JoseAMS17/MQ4/Documentacion/Plantilla Especificación de requisitos de software IEEE-830.docx

Especificación de requisitos de software

Proyecto: MQ4 — Carrito a control remoto

Revisión 1.00

| | Octubre de 2026

Instrucciones para el uso de este formato

Este formato es una plantilla tipo para documentos de requisitos del software.

Está basado y es conforme con el estándar IEEE Std 830-1998.

Las secciones que no se consideren aplicables al sistema descrito podrán de forma justificada indicarse como no aplicables (NA).

Notas:

Los textos en color azul son indicaciones que deben eliminarse y, en su caso, sustituirse por los contenidos descritos en cada apartado.

Los textos entre corchetes del tipo “” permiten la inclusión directa de texto con el color y estilo adecuado a la sección, al pulsar sobre ellos con el puntero del ratón.

Los títulos y subtítulos de cada apartado están definidos como estilos de MS Word, de forma que su numeración consecutiva se genera automáticamente según se trate de estilos “Titulo1, Titulo2 y Titulo3”.

La sangría de los textos dentro de cada apartado se genera automáticamente al pulsar Intro al final de la línea de título. (Estilos Normal indentado1, Normal indentado 2 y Normal indentado 3).

El índice del documento es una tabla de contenido que MS Word actualiza tomando como criterio los títulos del documento.

Una vez terminada su redacción debe indicarse a Word que actualice todo su contenido para reflejar el contenido definitivo.

De la plantilla de formato del documento © & Coloriuris http://www.qualitatis.org

# Ficha del documento

Fecha | Revisión | Autor | Verificado dep. calidad.
07/10/2026 | 1.00 | Grupo MQ4 — primera redacción completa del documento. Las cifras marcadas PRELIMINAR están pendientes de confirmación. | [Pendiente]

Documento validado por las partes en fecha: [Pendiente]

Por el cliente | Por la empresa suministradora
Fdo. D./ Dña [Pendiente — docente responsable de la asignatura] | Fdo. D./Dña [Pendiente — representante del Grupo MQ4]

# Contenido

# 1 Introducción

Este documento es la especificación de requisitos de software del proyecto MQ4, un carrito de control remoto construido como demostrador de electrónica de potencia, PWM y puente H. Está redactado conforme al estándar IEEE Std 830-1998 [R1] y se organiza en cuatro capítulos: el primero fija el propósito, el alcance, el personal involucrado, las definiciones y las referencias; el segundo describe el producto, sus usuarios, sus restricciones y las suposiciones de las que depende; el tercero recoge los requisitos, que son la parte central del documento; y el cuarto reúne los apéndices. Su contenido parte del levantamiento de requisitos realizado con el docente de la asignatura [R3] [R4] y de la propuesta de proyecto elaborada por el equipo [R2].

## 1.1 Propósito

El propósito de este documento es definir los requisitos necesarios para el diseño y desarrollo del proyecto MQ4, un carrito de control remoto orientado a la aplicación práctica de conceptos de electrónica de potencia y diseño mecatrónico.

El documento está dirigido principalmente a los estudiantes encargados del desarrollo del proyecto y al docente responsable de la asignatura, sirviendo como referencia para establecer las funcionalidades, restricciones, interfaces y características que deberá cumplir el prototipo.

## 1.2 Alcance

El proyecto MQ4 consiste en el diseño y la construcción de un carrito de control remoto orientado a la aplicación práctica de principios de diseño mecatrónico y de electrónica de potencia. El sistema estará compuesto por un vehículo móvil, motores eléctricos, una etapa de potencia basada en un puente H, una unidad de control, un sistema de alimentación mediante baterías, luces delanteras y traseras, y un receptor que se comunica de forma inalámbrica con el control remoto suministrado por el docente de la asignatura.

El control de los motores deberá realizarse mediante señales PWM, lo que permite regular la velocidad de forma gradual y no solo encender y apagar. El puente H permitirá invertir el sentido de giro de los motores, de modo que el vehículo pueda avanzar, retroceder y girar hacia ambos lados. Las luces delanteras y traseras se encenderán y se apagarán por comando del operador.

El control remoto no se diseña ni se construye en este proyecto: es un equipo ya existente, suministrado por el docente, que fue utilizado en la competencia de la NASA en la que participó la universidad. Por lo tanto, el alcance del MQ4 comprende únicamente el lado del vehículo, es decir, el receptor compatible con ese control, la unidad de control, la etapa de potencia, el sistema de luces y el sistema de alimentación. La tecnología concreta del enlace —radiocontrol convencional, Bluetooth, Wi-Fi o ESP-NOW— se determinará al caracterizar el control en la primera etapa del proyecto, y de ese resultado dependen la elección del receptor y la del microcontrolador.

El alcance se limita al manejo remoto del vehículo y al funcionamiento de los motores mediante PWM y puente H. Quedan expresamente fuera del alcance la conducción autónoma, el seguimiento de línea, la detección de obstáculos, el uso de cámara y el envío de telemetría a una computadora o a un teléfono. Dado que el presupuesto disponible es muy limitado, la selección de los componentes deberá realizarse considerando tanto los requisitos técnicos como el costo de implementación y la disponibilidad real de los materiales.

El entregable técnico principal es la placa de circuito impreso diseñada, fabricada y soldada por el equipo, que integra el puente H, el regulador y la unidad de control. No se considera cumplido el alcance si la etapa de potencia se resuelve con un módulo comercial ya armado, porque es precisamente esa placa la que demuestra los temas de la asignatura.

- Identificación del producto(s) a desarrollar mediante un nombre
- Consistencia con definiciones similares de documentos de mayor nivel (ej. Descripción del sistema) que puedan existir

## 1.3 Personal involucrado

Nombre | [Pendiente]
Rol | [Pendiente — por ejemplo: líder de proyecto, diseño de PCB, firmware, mecánica y chasis, documentación]
Categoría profesional | [Pendiente]
Responsabilidades | [Pendiente]
Información de contacto | [Pendiente — correo institucional]
Aprobación | [Pendiente]

Nombre | Junior A. Castillo
Rol | [Pendiente — por ejemplo: líder de proyecto, diseño de PCB, firmware, mecánica y chasis, documentación]
Categoría profesional | Estudiante
Responsabilidades | [Pendiente]
Información de contacto | 20240719@itla.edu.do
Aprobación | [Pendiente]

Nombre | [Pendiente]
Rol | [Pendiente — por ejemplo: líder de proyecto, diseño de PCB, firmware, mecánica y chasis, documentación]
Categoría profesional | [Pendiente]
Responsabilidades | [Pendiente]
Información de contacto | [Pendiente — correo institucional]
Aprobación | [Pendiente]

Nombre | [Pendiente]
Rol | [Pendiente — por ejemplo: líder de proyecto, diseño de PCB, firmware, mecánica y chasis, documentación]
Categoría profesional | [Pendiente]
Responsabilidades | [Pendiente]
Información de contacto | [Pendiente — correo institucional]
Aprobación | [Pendiente]

PENDIENTE. La relación de integrantes del Grupo MQ4 está por completar. Esta tabla debe replicarse una vez por cada integrante del equipo y una vez por el docente responsable de la asignatura, indicando en cada caso nombre, rol dentro del proyecto, categoría profesional, responsabilidades asignadas, información de contacto y constancia de aprobación. Es el único apartado del documento que queda sin contenido definitivo.

Relación de personas involucradas en el desarrollo del sistema, con información de contacto.

Esta información es útil para que el gestor del proyecto pueda localizar a todos los participantes y recabar la información necesaria para la obtención de requisitos, validaciones de seguimiento, etc.

## 1.4 Definiciones, acrónimos y abreviaturas

Bluetooth: tecnología de comunicación inalámbrica utilizada para transmitir información entre dispositivos compatibles a corta distancia.

Ciclo de trabajo: proporción del tiempo en que una señal PWM permanece en estado activo dentro de cada período. Un ciclo de trabajo del 50 % entrega al motor la mitad de la energía disponible.

Control remoto: dispositivo utilizado por el operador para enviar comandos al carrito MQ4 y controlar su movimiento. En el proyecto MQ4 el control remoto es un equipo ya existente, suministrado por el docente de la asignatura, y no forma parte del producto a desarrollar.

Corriente de arranque: pico de corriente que demanda un motor en el instante en que empieza a girar. Es notablemente mayor que la corriente de marcha y es la que determina el dimensionamiento de los transistores del puente H.

Driver: circuito que recibe una señal de baja corriente desde el microcontrolador y la convierte en la señal capaz de gobernar los transistores de potencia.

Electrónica de potencia: área de la electrónica dedicada al control y la conversión de la energía eléctrica para alimentar y controlar diferentes tipos de cargas.

ERS: especificación de requisitos de software (en inglés, SRS). Documento definido por el estándar IEEE Std 830-1998, del cual este texto es una instancia.

ESP-NOW: protocolo de comunicación inalámbrica desarrollado por Espressif que permite la comunicación directa y de baja latencia entre dispositivos compatibles con ESP32.

ESP32: familia de microcontroladores desarrollados por Espressif que incorporan capacidades de procesamiento y de comunicación inalámbrica, como Wi-Fi y Bluetooth.

IEEE Std 830-1998: estándar que establece la práctica recomendada para la redacción de especificaciones de requisitos de software y que da estructura a este documento.

MQ4: nombre asignado al proyecto correspondiente al diseño y la construcción del carrito de control remoto.

Operador: persona que maneja el MQ4 mediante el control remoto.

PCB: placa de circuito impreso. Tarjeta sobre la que se sueldan los componentes y cuyas pistas de cobre sustituyen al cableado.

PRELIMINAR: marca que acompaña en este documento a todo valor numérico propuesto por el equipo y todavía no confirmado mediante medición sobre el hardware real.

Protoboard: tablero de pruebas que permite armar y verificar un circuito sin soldar, antes de fabricar la placa.

Puente H: circuito electrónico utilizado para controlar el sentido de giro de un motor eléctrico mediante la modificación de la dirección de la corriente que circula por él. Recibe su nombre de la disposición de sus cuatro interruptores alrededor del motor.

PWM (Pulse Width Modulation): técnica de control que utiliza una señal de pulsos para regular la potencia promedio entregada a una carga mediante la variación de su ciclo de trabajo.

Receptor: elemento del carrito que recibe la señal del control remoto y la entrega a la unidad de control.

Regulador: circuito que reduce y estabiliza la tensión de la batería para alimentar la electrónica de control.

Riel de control: línea de alimentación de baja tensión y bajo ruido, procedente del regulador, que alimenta el microcontrolador y el receptor.

Riel de potencia: línea de alimentación que conecta la batería directamente con el puente H y los motores, sin pasar por la electrónica de control.

Tiempo muerto: pausa breve que se deja entre el apagado de un interruptor del puente H y el encendido del opuesto del mismo brazo, para impedir un cortocircuito sobre la batería.

Unidad de control: elemento electrónico encargado de procesar los comandos recibidos del control remoto y de generar las señales necesarias para controlar el funcionamiento del vehículo.

## 1.5 Referencias

Referencia | Titulo | Ruta | Fecha | Autor
[R1] | IEEE Std 830-1998 — IEEE Recommended Practice for Software Requirements Specifications | Estándar publicado por el IEEE | 1998 | IEEE Computer Society
[R2] | MQ4 — Propuesta de proyecto (carrito a control) | ELECTIVA/MQ4 - Propuesta de proyecto (carrito a control).docx | 17/09/2026 | Grupo MQ4
[R3] | Carrito — Levantamiento de requisitos | ELECTIVA/Carrito - Levantamiento de requisitos.docx | 17/09/2026 | Grupo MQ4
[R4] | Cuáles son los temas de aprendizaje para demostrar en el carrito (notas de la reunión con el docente) | ELECTIVA/cuales son los temas de aprendizaje para demostrar en el carrito.docx | 17/09/2026 | Grupo MQ4
[R5] | MQ4 — Diagrama de bloques (Figura 1) | ELECTIVA/MQ4 - Diagrama de bloques.png | 17/09/2026 | Grupo MQ4

## 1.6 Resumen

Este documento presenta la especificación de requisitos del proyecto MQ4, un carrito de control remoto desarrollado como plataforma práctica para la aplicación de conceptos de electrónica de potencia y diseño mecatrónico.

El documento describe el propósito y alcance del proyecto, las personas involucradas, los conceptos utilizados, las funcionalidades principales, las restricciones de diseño y los requisitos que deberá cumplir el sistema.

Las cifras de los requisitos acompañadas de la marca PRELIMINAR son valores propuestos por el equipo a partir del diseño previsto. Deberán confirmarse al caracterizar el control remoto suministrado por el docente y al medir el motor y la batería disponibles. Su confirmación no cambia la redacción del requisito, solo su cifra.

# 2 Descripción general

## 2.1 Perspectiva del producto

El MQ4 será un prototipo de vehículo móvil controlado de forma remota. El sistema estará compuesto por una unidad de control, una fuente de alimentación mediante baterías, un regulador, una etapa de potencia para los motores, los motores eléctricos, las luces delanteras y traseras, y un receptor inalámbrico que recibe las órdenes del control remoto.

El MQ4 no es un producto completamente independiente: forma parte de un sistema mayor compuesto por dos elementos. El primero es el control remoto, que suministra el docente y que no se desarrolla en este proyecto. El segundo es el vehículo, que es el producto para desarrollar. La frontera entre ambos es el enlace inalámbrico. La tecnología de ese enlace está sujeta a la caracterización del control y es la que determina tanto el receptor como el microcontrolador del vehículo, que podrá ser un ESP32, un ATmega328P u otro equivalente, según los criterios de selección recogidos en la propuesta de proyecto [R2].

La etapa de potencia incorporará un puente H gobernado mediante PWM, lo que permite invertir el sentido de giro y regular la velocidad de los motores. La batería alimenta dos rieles separados: el riel de potencia, que llega directamente al puente H con la tensión que piden los motores, y el riel de control, que pasa por un regulador y entrega una tensión baja y estable al microcontrolador y al receptor. Esa separación es deliberada y constituye la demostración práctica del tema de electrónica de potencia. La Figura 1, incluida en el Apéndice A, sitúa el producto dentro del sistema e identifica sus conexiones.

## 2.2 Funcionalidad del producto

Las principales funcionalidades previstas para el MQ4 son:

- Permitir el control remoto del vehículo.
- Recibir comandos mediante comunicación inalámbrica.
- Procesar los comandos recibidos por medio de la unidad de control.
- Generar señales PWM para controlar los motores.
- Controlar el sentido de giro de los motores mediante un puente H.
- Permitir el desplazamiento del vehículo de acuerdo con las órdenes del operador.
- Utilizar baterías como fuente de alimentación del sistema.
- Encender y apagar las luces delanteras y traseras por comando del operador.
- Detener los motores de forma automática ante la pérdida de la señal del control remoto.
- Informar al operador del nivel de carga de la batería.
- Separar la alimentación de potencia de la alimentación de control mediante un regulador.
- Servir como plataforma práctica para demostrar la aplicación de electrónica de potencia, PWM y puente H.

## 2.3 Características de los usuarios

Tipo de usuario | Operador del vehículo: estudiante del Grupo MQ4 o docente de la asignatura.
Formación | Estudios técnicos de nivel superior en curso. No se requiere formación específica en electrónica para manejar el carrito.
Habilidades | Manejo de un control remoto de palancas. Capacidad de encender el vehículo, interpretar el indicador de nivel de batería y detenerlo ante cualquier anomalía.
Actividades | Conducir el MQ4 en el aula y en la pista, encender y apagar las luces, cargar y sustituir las baterías, y cortar la alimentación mediante el interruptor general.

Tipo de usuario | Equipo de desarrollo y mantenimiento: integrantes del Grupo MQ4.
Formación | Estudiantes de carrera tecnológica con formación en electrónica analógica y digital, diseño de circuito impreso y programación de microcontroladores.
Habilidades | Lectura e interpretación de esquemáticos, soldadura, uso de multímetro y osciloscopio, trazado de PCB y programación en C/C++.
Actividades | Diseñar, fabricar, programar, calibrar, probar, reparar y documentar el vehículo, y medir el motor y la batería disponibles.

## 2.4 Restricciones

El diseño y el desarrollo del MQ4 están sujetos a las siguientes limitaciones:

Presupuesto. El docente indicó que el presupuesto es muy limitado. Se reutilizará todo el material disponible y solo se comprará lo insustituible.

Componentes. No existe un kit obligatorio ni restricción de marca o familia de componentes. La selección queda condicionada a lo que haya disponible en el laboratorio y a lo que se consiga en el país dentro del plazo.

Control remoto. El control lo suministra el docente y no puede modificarse. El vehículo debe adaptarse a él, y no al revés.

Etapa de potencia. El puente H debe diseñarse y fabricarse sobre una placa propia. No se admite resolver esta etapa con un módulo comercial ya armado (requisito RF-13).

Alimentación. El MQ4 se alimenta exclusivamente mediante baterías. No se admite alimentación por cable desde la red eléctrica.

Motor. La potencia, la tensión y la corriente del motor no están definidas: se empleará el motor que esté disponible. De su medición dependen el dimensionamiento del puente H, el ancho de las pistas de la placa y el tamaño del banco de baterías.

Dimensiones. Las dimensiones físicas del vehículo quedan determinadas por el chasis, las ruedas y la batería disponibles. El tamaño individual de cada celda de batería no deberá superar los [X] cm (PRELIMINAR, por confirmar al seleccionar la batería).

Ambiente de uso. El MQ4 se operará en el aula y en la pista, en interiores, sobre superficie plana y seca. No se contempla uso en exteriores ni resistencia al agua o al polvo.

Seguridad eléctrica. El puente H debe incluir tiempo muerto entre las conmutaciones de un mismo brazo (requisito RF-04) y los rieles de potencia y de control deben mantenerse separados (requisito RF-14).

Plazo. El desarrollo se ajusta al calendario de la asignatura y al plan de trabajo por etapas recogido en la propuesta de proyecto [R2].

## 2.5 Suposiciones y dependencias

Los requisitos de este documento se apoyan en las siguientes suposiciones. Si alguna deja de cumplirse, la especificación debe revisarse.

El docente facilitará el control remoto y la información necesaria para caracterizar su enlace antes de iniciar el diseño del receptor. Es la dependencia bloqueante del proyecto: de ella dependen la elección del receptor, la del microcontrolador y la redacción definitiva del requisito RF-09 y del apartado 3.1.4.

Se supone que habrá motores, chasis y batería disponibles para reutilizar. El dimensionamiento del banco de baterías depende del tamaño de las celdas que se consigan, y la autonomía depende de su capacidad.

Se supone que la corriente de arranque del motor disponible está dentro de lo que puede manejar un puente H construido con componentes discretos accesibles en el mercado local. Si resultara mayor, habría que revisar los requisitos RF-03, RF-04 y RF-12.

Se supone que el equipo dispondrá de un servicio de fabricación de circuito impreso dentro del plazo. En caso contrario, el prototipo armado en protoboard se mantiene como respaldo de la demostración.

Se supone que el control remoto dispone de al menos un canal libre, además de los de dirección y velocidad, para el mando de las luces. Si no lo tuviera, el requisito RF-10 pasaría a resolverse con un interruptor en el propio vehículo.

Todas las cifras marcadas PRELIMINAR son suposiciones del equipo. Se confirmarán mediante medición y, si cambian, los requisitos afectados deberán actualizarse en una revisión posterior de este documento.

## 2.6 Evolución previsible del sistema

Las siguientes mejoras quedan fuera del alcance de esta revisión, pero el diseño no debe impedirlas:

Telemetría hacia una computadora o un teléfono, para registrar el comportamiento del vehículo durante las pruebas.

Seguimiento de línea y detección de obstáculos, que convertirían al MQ4 en una plataforma parcialmente autónoma.

Luces adicionales: intermitentes de giro y luz de freno diferenciada de la luz de posición trasera.

Segunda revisión de la placa con transistores de menor resistencia de conducción, para reducir el calentamiento del puente H y aumentar la autonomía.

Aumento de la autonomía mediante una batería de mayor capacidad o un sistema de carga incorporado al vehículo.

Para no impedir ninguna de estas mejoras, el trazado de la placa deberá reservar pines libres del microcontrolador y espacio físico suficiente, de modo que puedan incorporarse sin rediseñar la tarjeta completa.

# 3 Requisitos específicos

Convenciones de esta sección. Los requisitos se identifican como RF-nn y se numeran de forma correlativa según su orden de aparición. Cada requisito se expresa en la forma «el sistema deberá (acción) cuando (condición), con (valor cuantificable) y (grado de error)», de modo que pueda comprobarse mediante una prueba y no mediante una opinión. Los valores acompañados de la marca PRELIMINAR son propuestas del equipo que deberán confirmarse al caracterizar el control remoto y al medir el motor y la batería disponibles; el Apéndice E los reúne todos e indica de qué dato depende cada uno. La casilla «Tipo» distingue entre requisito propiamente dicho y restricción de diseño.

Número de requisito | RF-01
Nombre de requisito | Recepción de comandos
Tipo | [x] Requisito | [ ] Restricción
Fuente del requisito | Docente de la asignatura: el carrito debe ser controlado de forma remota [R4].
Prioridad del requisito | [x] Alta/Esencial | [ ] Media/Deseado | [ ] Baja/ Opcional

El MQ4 deberá recibir y ejecutar los comandos enviados desde el control remoto suministrado por el docente cuando la distancia entre el control y el vehículo sea igual o menor a 30 metros en línea de vista, con una tasa de recepción correcta de al menos el 90 % de las tramas enviadas. (PRELIMINAR: la distancia y la tasa se confirmarán al medir el alcance real del control.)

Número de requisito | RF-02
Nombre de requisito | Respuesta al comando
Tipo | [x] Requisito | [ ] Restricción
Fuente del requisito | Equipo de desarrollo: requisito de manejabilidad derivado de la prueba en pista [R2, sección 9].
Prioridad del requisito | [x] Alta/Esencial | [ ] Media/Deseado | [ ] Baja/ Opcional

El MQ4 deberá reflejar en el movimiento de los motores un comando recibido desde el control remoto en un tiempo máximo de 150 ms contados desde la recepción de la trama, con un error máximo de ±20 ms, en al menos el 95 % de los comandos medidos. (PRELIMINAR.)

Número de requisito | RF-03
Nombre de requisito | Control de velocidad mediante PWM
Tipo | [x] Requisito | [ ] Restricción
Fuente del requisito | Docente de la asignatura: temas de aprendizaje a demostrar en el carrito [R4].
Prioridad del requisito | [x] Alta/Esencial | [ ] Media/Deseado | [ ] Baja/ Opcional

El MQ4 deberá controlar la velocidad de los motores mediante modulación por ancho de pulso dentro de un rango de ciclo de trabajo del 10 % al 95 %, con una resolución mínima del 0,5 % —equivalente a 8 bits— y una frecuencia de conmutación de 20 kHz con una tolerancia del ±10 % en todo el rango. (PRELIMINAR: la frecuencia se elige por encima de 20 kHz para que la conmutación quede fuera del rango audible, y se confirmará tras medir el calentamiento del puente H con el motor real.)

Número de requisito | RF-04
Nombre de requisito | Control del sentido de giro mediante puente H
Tipo | [x] Requisito | [ ] Restricción
Fuente del requisito | Docente de la asignatura: temas de aprendizaje a demostrar en el carrito [R4].
Prioridad del requisito | [x] Alta/Esencial | [ ] Media/Deseado | [ ] Baja/ Opcional

El MQ4 deberá invertir el sentido de giro de los motores mediante el puente H cuando el operador envíe un comando de dirección contraria, completando el cambio en un tiempo máximo de 100 ms e intercalando un tiempo muerto no menor a 1 µs entre el apagado de un interruptor y el encendido del opuesto del mismo brazo. En ningún caso deberán conducir simultáneamente los dos interruptores de un mismo brazo. (PRELIMINAR: el tiempo muerto definitivo se calculará con los tiempos de conmutación de los transistores seleccionados.)

Número de requisito | RF-05
Nombre de requisito | Movimiento del vehículo
Tipo | [x] Requisito | [ ] Restricción
Fuente del requisito | Docente de la asignatura: el carrito debe ser controlado de forma remota [R4].
Prioridad del requisito | [x] Alta/Esencial | [ ] Media/Deseado | [ ] Baja/ Opcional

El MQ4 deberá ejecutar el movimiento correspondiente al comando recibido —avanzar, retroceder, girar a la izquierda y girar a la derecha— cuando reciba una orden válida desde el control remoto, con una tasa de ejecución correcta de al menos el 95 % sobre 50 repeticiones de cada maniobra durante las pruebas de aceptación. (PRELIMINAR.)

Número de requisito | RF-06
Nombre de requisito | Alimentación mediante baterías
Tipo | [x] Requisito | [ ] Restricción
Fuente del requisito | Docente de la asignatura: alimentación por baterías, según disponibilidad [R4].
Prioridad del requisito | [x] Alta/Esencial | [ ] Media/Deseado | [ ] Baja/ Opcional

El MQ4 deberá alimentarse exclusivamente mediante baterías, operar con una tensión nominal de 12 V de corriente continua y mantener su funcionamiento completo dentro del rango de 6 V a 18 V, es decir, 12 V ±6 V, sin que la electrónica de control se reinicie durante los picos de corriente de arranque de los motores. (PRELIMINAR: la tensión nominal se confirmará al disponer de la batería y del motor reales.)

Número de requisito | RF-07
Nombre de requisito | Parada por pérdida de comunicación
Tipo | [x] Requisito | [ ] Restricción
Fuente del requisito | Equipo de desarrollo: requisito de seguridad para la operación en el aula y en la pista [R2, sección 3].
Prioridad del requisito | [x] Alta/Esencial | [ ] Media/Deseado | [ ] Baja/ Opcional

El MQ4 deberá detener los motores y llevar el ciclo de trabajo del PWM al 0 % cuando no reciba ninguna trama válida del control remoto durante un período superior a 500 ms, completando la parada en un máximo de 500 ms adicionales y con un error máximo de ±50 ms. El vehículo no deberá reanudar el movimiento por sí solo al restablecerse el enlace: requerirá que el operador envíe un nuevo comando de movimiento. (PRELIMINAR.)

Número de requisito | RF-08
Nombre de requisito | Vinculación con el control remoto
Tipo | [x] Requisito | [ ] Restricción
Fuente del requisito | Necesidad declarada por el equipo: el vehículo debe conectarse al control suministrado por el docente.
Prioridad del requisito | [x] Alta/Esencial | [ ] Media/Deseado | [ ] Baja/ Opcional

El MQ4 deberá establecer la vinculación con el control remoto suministrado por el docente en un tiempo máximo de 5 segundos desde que ambos equipos quedan energizados, en al menos 9 de cada 10 intentos, sin requerir del operador ninguna acción distinta de encender el vehículo. Mientras la vinculación no se haya establecido, el vehículo deberá permanecer con los motores detenidos. (PRELIMINAR: el tiempo depende de la tecnología del enlace y se confirmará al caracterizar el control.)

Número de requisito | RF-09
Nombre de requisito | Enlace inalámbrico con el control remoto
Tipo | [x] Requisito | [ ] Restricción
Fuente del requisito | Docente de la asignatura: el control remoto lo suministra él [R4]. Dependencia abierta registrada en el apartado 2.5.
Prioridad del requisito | [x] Alta/Esencial | [ ] Media/Deseado | [ ] Baja/ Opcional

El MQ4 deberá mantener el enlace inalámbrico con el control remoto mientras ambos equipos se encuentren dentro del alcance definido para la tecnología de ese control, con una tasa de tramas válidas de al menos el 95 % medida a 30 metros en línea de vista. La tecnología concreta del enlace —radiocontrol convencional con su receptor, Bluetooth, Wi-Fi o ESP-NOW— queda determinada por el control suministrado y se confirmará en la primera etapa del proyecto. (PRELIMINAR.)

Número de requisito | RF-10
Nombre de requisito | Luces delanteras y traseras
Tipo | [x] Requisito | [ ] Restricción
Fuente del requisito | Necesidad declarada por el equipo: el vehículo debe incluir luces delanteras y traseras que se enciendan.
Prioridad del requisito | [x] Alta/Esencial | [ ] Media/Deseado | [ ] Baja/ Opcional

El MQ4 deberá encender y apagar sus luces delanteras y traseras cuando el operador accione el mando correspondiente del control remoto, en un tiempo máximo de 200 ms desde la recepción del comando, y deberá conservar el estado seleccionado hasta que reciba un nuevo comando. Las luces deberán ser visibles a 5 metros en las condiciones de iluminación del aula. (PRELIMINAR: la visibilidad depende de los LED que se seleccionen, y la disponibilidad de un canal libre en el control está registrada como suposición en el apartado 2.5.)

Número de requisito | RF-11
Nombre de requisito | Indicación del nivel de carga de la batería
Tipo | [x] Requisito | [ ] Restricción
Fuente del requisito | Equipo de desarrollo: requisito propuesto durante el levantamiento de requisitos.
Prioridad del requisito | [ ] Alta/Esencial | [x] Media/Deseado | [ ] Baja/ Opcional

El MQ4 deberá calcular e indicar el nivel de carga actual de la batería con un error menor al 5 % respecto a la medición tomada con un instrumento de referencia, actualizando la indicación al menos una vez por segundo. La indicación deberá ser perceptible por el operador sin necesidad de detener el vehículo. (PRELIMINAR: el método de indicación, mediante LED de tres estados o escala de LED, se definirá en la etapa de diseño.)

Número de requisito | RF-12
Nombre de requisito | Aceleración
Tipo | [x] Requisito | [ ] Restricción
Fuente del requisito | Equipo de desarrollo: requisito propuesto durante el levantamiento de requisitos.
Prioridad del requisito | [ ] Alta/Esencial | [x] Media/Deseado | [ ] Baja/ Opcional

El MQ4 deberá alcanzar el 50 % de su velocidad máxima en un tiempo no mayor a 2 segundos desde el reposo cuando el operador lleve el mando de velocidad a esa posición, con un error máximo de ±0,5 s, sobre superficie plana y seca. (PRELIMINAR: la cifra depende del motor, de la relación de transmisión y del peso final del vehículo; se confirmará tras la primera prueba en pista.)

Número de requisito | RF-13
Nombre de requisito | Etapa de potencia sobre placa diseñada por el equipo
Tipo | [ ] Requisito | [x] Restricción
Fuente del requisito | Docente de la asignatura: diseñar el circuito impreso en función del motor [R4].
Prioridad del requisito | [x] Alta/Esencial | [ ] Media/Deseado | [ ] Baja/ Opcional

La etapa de potencia del MQ4 —puente H, regulador y unidad de control— deberá implementarse sobre una placa de circuito impreso diseñada, fabricada y soldada por el equipo, dimensionada para la corriente de arranque del motor disponible medida previamente. No se admite resolver esta etapa mediante un módulo comercial ya armado.

Número de requisito | RF-14
Nombre de requisito | Separación de la alimentación de potencia y de control
Tipo | [ ] Requisito | [x] Restricción
Fuente del requisito | Equipo de desarrollo: riesgo de reinicio del microcontrolador por el ruido eléctrico de los motores [R2, sección 10].
Prioridad del requisito | [x] Alta/Esencial | [ ] Media/Deseado | [ ] Baja/ Opcional

La alimentación del puente H y de los motores deberá tomarse directamente de la batería, y la alimentación del microcontrolador y del receptor deberá proceder de un regulador independiente, sin que ambos rieles compartan más que el nodo de referencia común. El microcontrolador no deberá reiniciarse durante diez arranques consecutivos del motor a plena carga.

## 3.1 Requisitos comunes de los interfaces

El MQ4 no es un sistema de información: sus entradas y sus salidas son eléctricas y físicas, no pantallas ni ficheros. Las entradas del sistema son la trama de comandos que llega desde el control remoto, la tensión de la batería y la posición del interruptor general. Las salidas son las señales de PWM y de sentido de giro hacia el puente H, la corriente entregada a los motores, el estado de las luces y la indicación del nivel de carga.

### 3.1.1 Interfaces de usuario

El operador no interactúa con ninguna pantalla ni con ningún programa de computadora, por lo que no procede especificar colores ni estilo gráfico. La interfaz de usuario del MQ4 se compone de cuatro elementos:

— El control remoto suministrado por el docente, con el que se gobiernan la dirección, la velocidad y el encendido de las luces.

— Un interruptor general en el vehículo, accesible sin desarmarlo, que corta la alimentación de los dos rieles.

— Un indicador luminoso del nivel de carga de la batería, visible con el vehículo en marcha (requisito RF-11).

— Las luces delanteras y traseras, que además de iluminar informan de que el vehículo está energizado (requisito RF-10).

El criterio de diseño de esta interfaz es que cualquier persona presente en el aula pueda detener el vehículo sin conocer su electrónica.

### 3.1.2 Interfaces de hardware

Las interfaces entre el producto y los componentes de hardware del sistema son las siguientes:

— Receptor con unidad de control. Entrega la trama de comandos. El formato eléctrico —PPM, una señal PWM por canal, SBUS, UART, o un enlace integrado en el propio microcontrolador— queda determinado por el control suministrado por el docente y se fija en la primera etapa del proyecto.

— Unidad de control con puente H. Hasta cuatro señales lógicas por motor: las de sentido de giro y las de PWM, en niveles de 3,3 V o de 5 V según el microcontrolador elegido. Si los niveles del microcontrolador y los del driver no coinciden, se intercalará una adaptación de nivel.

— Puente H con motores. Dos terminales por motor, dimensionados para la corriente de arranque medida. Cada motor llevará condensadores de supresión en sus terminales para reducir el ruido eléctrico.

— Batería con puente H (riel de potencia). Conexión directa, sin pasar por la electrónica de control, con protección contra inversión de polaridad y con un elemento de protección contra sobrecorriente.

— Batería con regulador, y regulador con unidad de control y receptor (riel de control). Tensión estabilizada de 3,3 V o de 5 V, con condensadores de desacople junto a cada circuito integrado.

— Unidad de control con el driver de luces. Una o dos señales lógicas de encendido, según se gobiernen las luces delanteras y traseras de forma conjunta o separada.

— Conector de programación y puntos de prueba en la placa, para cargar el firmware y medir las señales sin desoldar componentes.

Los valores concretos de tensión y de corriente de cada interfaz se fijarán al medir el motor y la batería disponibles, y quedarán recogidos en el esquemático.

### 3.1.3 Interfaces de software

El MQ4 no se integra con ningún otro producto de software. El firmware se ejecuta de forma autónoma en el microcontrolador del vehículo y no intercambia datos con aplicaciones externas, por lo que en esta revisión no existen interfaces de software en el sentido del estándar.

Las herramientas utilizadas durante el desarrollo no forman parte del producto entregado, pero se dejan indicadas por trazabilidad:

— Entorno de desarrollo del firmware (Arduino IDE o PlatformIO), empleado para compilar el programa y cargarlo en el microcontrolador.

— Herramienta de diseño electrónico (KiCad o equivalente), empleada para el esquemático, el trazado de la placa y la generación de los archivos de fabricación.

Si en una revisión futura se incorporara la telemetría prevista en el apartado 2.6, este apartado deberá desarrollarse indicando el producto de software utilizado, el propósito de la interfaz y el contenido y formato de los mensajes intercambiados.

### 3.1.4 Interfaces de comunicación

La única comunicación del MQ4 con el exterior es el enlace inalámbrico con el control remoto suministrado por el docente, descrito en el requisito RF-09. El MQ4 actúa siempre como receptor: no transmite información hacia el control ni hacia ningún otro equipo.

El protocolo concreto no puede fijarse en esta revisión, porque depende de un control que todavía no se ha caracterizado. Las alternativas previstas son:

— Radiocontrol convencional en la banda de 2,4 GHz, con su receptor propio, que entrega los canales por cable a la unidad de control.

— Bluetooth, si el control se comporta como un dispositivo Bluetooth y el microcontrolador del vehículo lo admite.

— Wi-Fi o ESP-NOW, si el control está construido sobre un ESP32 y puede emparejarse directamente con otro ESP32 situado en el vehículo.

Sea cual sea la alternativa, el enlace deberá cumplir los requisitos RF-01, RF-08 y RF-09, y su pérdida deberá activar el comportamiento definido en RF-07. Este apartado se cerrará en la primera etapa del proyecto; es la dependencia bloqueante registrada en el apartado 2.5.

## 3.2 Requisitos funcionales

Los requisitos funcionales del MQ4 son los recogidos en las tablas RF-01 a RF-14 del comienzo de esta sección. A continuación se agrupan por función, para facilitar su lectura y su trazabilidad con las pruebas de verificación del Apéndice D. En todos los casos, la comprobación de validez de las entradas precede a cualquier acción sobre los motores: una trama incompleta o fuera de rango se descarta y nunca produce movimiento.

Definición de acciones fundamentales que debe realizar el software al recibir información, procesarla y producir resultados.

En ellas se incluye:

- Comprobación de validez de las entradas
- Secuencia exacta de operaciones
- Respuesta a situaciones anormales (desbordamientos, comunicaciones, recuperación de errores)
- Parámetros
- Generación de salidas
- Relaciones entre entradas y salidas (secuencias de entradas y salidas, formulas para la conversión de información)
- Especificación de los requisitos lógicos para la información que será almacenada en base de datos (tipo de información, requerido)

Las requisitos funcionales pueden ser divididos en sub-secciones.

### 3.2.1 Recepción y validación de comandos

Agrupa los requisitos RF-01, RF-08 y RF-09. El vehículo recibe del control remoto una trama con la posición de los mandos. La unidad de control deberá descartar toda trama que llegue incompleta o con valores fuera del rango esperado y tratarla como si no se hubiera recibido, de modo que una trama corrupta nunca produzca un movimiento. El conteo de tramas descartadas de forma consecutiva alimenta la condición de pérdida de comunicación descrita en el requisito RF-07.

### 3.2.2 Control de los motores

Agrupa los requisitos RF-02, RF-03, RF-04, RF-05 y RF-12. La unidad de control traduce la posición de los mandos en dos salidas por motor: el sentido de giro y el ciclo de trabajo. El ciclo de trabajo se limita por software al rango definido en RF-03; todo valor que quede fuera de ese rango se satura en el extremo correspondiente, nunca se ignora ni se deja pasar. Toda inversión de sentido pasa obligatoriamente por un ciclo de trabajo del 0 % y por el tiempo muerto definido en RF-04 antes de aplicar el sentido contrario.

### 3.2.3 Alimentación y supervisión de la batería

Agrupa los requisitos RF-06, RF-11 y RF-14. La unidad de control mide la tensión de la batería mediante un divisor resistivo y la convierte en un porcentaje de carga. La medición se promedia sobre al menos diez muestras, para que las caídas de tensión momentáneas del arranque no se interpreten como descarga. Cuando la tensión se mantenga por debajo del límite inferior del rango definido en RF-06, el sistema deberá señalarlo al operador mediante el indicador de nivel de carga.

### 3.2.4 Señalización luminosa y modo seguro

Agrupa los requisitos RF-07 y RF-10. El estado de las luces se conserva mientras no llegue un comando nuevo. Al entrar en modo seguro por pérdida de comunicación, el vehículo deberá detener los motores y mantener encendidas las luces, de modo que siga siendo visible dentro del aula o de la pista. La salida del modo seguro exige un comando explícito del operador y nunca se produce de forma automática al restablecerse el enlace.

## 3.3 Requisitos no funcionales

### 3.3.1 Requisitos de rendimiento

La carga que debe soportar el MQ4 es la de un único operador manejando un único vehículo: no hay usuarios concurrentes ni transacciones. Los requisitos de rendimiento aplicables son, por tanto, de tiempo de respuesta y de autonomía:

— El lazo de control deberá ejecutarse a una frecuencia mínima de 50 Hz, es decir, deberá leer los comandos y actualizar las salidas al menos una vez cada 20 ms.

— El 95 % de los comandos deberá reflejarse en el movimiento de los motores en menos de 150 ms (requisito RF-02).

— La señal PWM deberá mantener su frecuencia dentro del ±10 % del valor nominal en todo el rango de ciclo de trabajo (requisito RF-03).

— La autonomía con la batería disponible deberá ser de al menos 20 minutos de operación continua en pista. (PRELIMINAR.)

— La temperatura de los transistores del puente H no deberá superar el 80 % de la temperatura máxima indicada en su hoja de datos tras 10 minutos de operación continua. (PRELIMINAR.)

Especificación de los requisitos relacionados con la carga que se espera tenga que soportar el sistema. Por ejemplo, el número de terminales, el número esperado de usuarios simultáneamente conectados, número de transacciones por segundo que deberá soportar el sistema, etc.

Todos estos requisitos deben ser mesurables. Por ejemplo, indicando “el 95% de las transacciones deben realizarse en menos de 1 segundo”, en lugar de “los operadores no deben esperar a que se complete la transacción”.

### 3.3.2 Seguridad

El MQ4 no almacena ni transmite información sensible y no está expuesto a una red de datos, por lo que no se especifican técnicas criptográficas, registro de actividad ni control de accesos: en el sentido estricto del estándar, ese tipo de requisitos no es aplicable a este producto. Sí se especifican, en cambio, los requisitos de seguridad eléctrica y funcional que le corresponden:

— Parada automática de los motores ante la pérdida de la señal del control remoto, sin reanudación automática del movimiento (requisito RF-07).

— Tiempo muerto obligatorio en el puente H, que impide el cortocircuito de la batería a través de los dos interruptores de un mismo brazo (requisito RF-04).

— Separación de los rieles de potencia y de control (requisito RF-14).

— Protección contra inversión de polaridad y contra sobrecorriente en el riel de potencia.

— Interruptor general accesible, que corta la alimentación del vehículo sin necesidad de desarmarlo.

— La batería deberá quedar fijada dentro del chasis, sin terminales expuestos, y no deberá poder desprenderse durante la operación.

— Si el control remoto utiliza un enlace emparejable, el vehículo solo deberá aceptar tramas del control con el que esté vinculado (requisito RF-08), de modo que otro transmisor presente en el aula no pueda gobernarlo.

Especificación de elementos que protegerán al software de accesos, usos y sabotajes maliciosos, así como de modificaciones o destrucciones maliciosas o accidentales. Los requisitos pueden especificar:

- Empleo de técnicas criptográficas.
- Registro de ficheros con “logs” de actividad.
- Asignación de determinadas funcionalidades a determinados módulos.
- Restricciones de comunicación entre determinados módulos.
- Comprobaciones de integridad de información crítica.

### 3.3.3 Fiabilidad

Los factores de fiabilidad exigidos al MQ4, expresados como tiempo de operación sin incidentes y como número de ciclos sin fallo, son los siguientes:

— El MQ4 deberá operar de forma continua durante al menos 30 minutos sin ningún fallo que exija la intervención del equipo. (PRELIMINAR.)

— El microcontrolador no deberá reiniciarse en ninguna de diez sesiones de prueba de diez minutos cada una. El reinicio provocado por el ruido eléctrico de los motores se considera el modo de fallo más probable del sistema, y se combate con el requisito RF-14.

— El vehículo deberá soportar al menos 50 ciclos de encendido y apagado sin fallo de arranque.

— Las soldaduras y los conectores deberán resistir las vibraciones de la operación en pista. Se verificará repitiendo cinco veces la prueba de pista sin que aparezcan intermitencias ni pérdidas de contacto.

Especificación de los factores de fiabilidad necesaria del sistema. Esto se expresa generalmente como el tiempo entre los incidentes permisibles, o el total de incidentes permisible.

### 3.3.4 Disponibilidad

Los factores de disponibilidad exigidos al MQ4 son los siguientes:

— El MQ4 deberá estar operativo durante al menos el 95 % del tiempo asignado a cada sesión de clase o de demostración.

— La recarga o la sustitución de la batería no deberá exigir desarmar el vehículo y deberá completarse en menos de 2 minutos.

— Mientras la placa definitiva no esté verificada, el prototipo armado en protoboard se mantendrá montado y funcional como respaldo de la demostración, y no se desarmará hasta que la placa funcione.

Especificación de los factores de disponibilidad final exigidos al sistema. Normalmente expresados en % de tiempo en los que el software tiene que mostrar disponibilidad.

### 3.3.5 Mantenibilidad

El mantenimiento correctivo y evolutivo del MQ4 lo realiza el propio Grupo MQ4. El operador no realiza más mantenimiento que la carga de la batería. Para que ese mantenimiento sea posible dentro del plazo de la asignatura, se exige lo siguiente:

— La placa deberá incluir puntos de prueba accesibles para las señales de PWM, los dos rieles de alimentación y las salidas hacia los motores, de modo que puedan medirse sin desoldar componentes.

— Las conexiones a motores, batería y luces se harán mediante conectores, y no mediante soldadura directa al cable, para permitir sustituir un componente sin rehacer la placa.

— Se preferirán componentes de montaje pasante y encapsulados grandes frente a encapsulados muy pequeños, por facilidad de sustitución con el instrumental disponible en el laboratorio.

— El esquemático, el trazado de la placa, la lista de materiales y el firmware se mantendrán versionados, indicando la fecha y el autor de cada cambio.

— El firmware deberá estar comentado y organizado en módulos separados —lectura de comandos, control de motores, luces y supervisión de la batería—, de modo que un integrante distinto a su autor pueda modificarlo.

— Después de cada sesión en pista se revisarán soldaduras, conectores y fijación de la batería.

Identificación del tipo de mantenimiento necesario del sistema.

Especificación de quien debe realizar las tareas de mantenimiento, por ejemplo usuarios, o un desarrollador.

Especificación de cuando debe realizarse las tareas de mantenimiento. Por ejemplo, generación de estadísticas de acceso semanales y mensuales.

### 3.3.6 Portabilidad

El firmware deberá escribirse de forma que un cambio de microcontrolador no obligue a reescribirlo por completo, porque la elección definitiva del microcontrolador depende del control remoto y todavía no está cerrada. Para conseguirlo se exige lo siguiente:

— El código se escribirá en C/C++ estándar, reservando en módulos separados las partes que dependen del hardware: generación de PWM, lectura del receptor, lectura del conversor analógico-digital y salidas digitales.

— La lógica de control —traducción de comandos a sentido y ciclo de trabajo, modo seguro y gestión de luces— no deberá contener llamadas directas al hardware.

— Se evitarán las librerías propietarias o atadas a un único fabricante siempre que exista una alternativa equivalente.

— Los archivos de fabricación de la placa se entregarán en formato Gerber estándar, de modo que puedan fabricarse en cualquier proveedor.

— Las señales que salen de la unidad de control se diseñarán tolerantes a 3,3 V y a 5 V, para no condicionar la elección del microcontrolador.

Especificación de atributos que debe presentar el software para facilitar su traslado a otras plataformas u entornos. Pueden incluirse:

- Porcentaje de componentes dependientes del servidor.
- Porcentaje de código dependiente del servidor.
- Uso de un determinado lenguaje por su portabilidad.
- Uso de un determinado compilador o plataforma de desarrollo.
- Uso de un determinado sistema operativo.

## 3.4 Otros requisitos

Requisitos académicos. El MQ4 es un trabajo de la asignatura electiva y debe demostrar de forma visible los tres temas indicados por el docente: electrónica de potencia, PWM y puente H. La demostración se considera cumplida únicamente si la etapa de potencia está construida sobre la placa diseñada por el equipo (requisito RF-13).

Requisitos de documentación. Junto con el vehículo se entregarán el esquemático, el trazado de la placa, la lista de materiales con sus costos, el firmware, los resultados de las pruebas de verificación y la presentación de la propuesta.

Requisitos económicos. El presupuesto es muy limitado. Ante un conflicto entre alcance y presupuesto, se descarta primero lo de prioridad media —RF-11 y RF-12— y nunca lo de prioridad alta. Se reutilizará todo el material disponible y solo se comprará lo insustituible.

Requisitos legales y normativos. El MQ4 es un prototipo académico de uso interno. No se somete a certificación de compatibilidad electromagnética ni de seguridad de producto y no está destinado a comercialización. Si el enlace se resolviera con un módulo de radio, se empleará un módulo comercial ya certificado en lugar de diseñar una etapa de radiofrecuencia propia.

Requisitos de operación. El MQ4 se opera en el aula y en la pista, bajo supervisión, en interiores y sobre superficie plana y seca.

Cualquier otro requisito que no encaje en ninguna de las secciones anteriores.

Por ejemplo:

Requisitos culturales y políticos

Requisitos Legales

# 4 Apéndices

Apéndice A. Diagrama de bloques del sistema (Figura 1). Archivo: ELECTIVA/MQ4 - Diagrama de bloques.png [R5]. Muestra la cadena de control —control, receptor, microcontrolador, puente H y motores— y la cadena de alimentación —batería hacia el riel de potencia, y batería hacia el regulador y el riel de control—. Los bloques dibujados con borde punteado son los que dependen de la caracterización del control remoto.

Apéndice B. Levantamiento de requisitos: preguntas planteadas al docente y respuestas obtenidas. Archivo: ELECTIVA/Carrito - Levantamiento de requisitos.docx [R3].

Apéndice C. Propuesta de proyecto, con el plan de trabajo por etapas, los riesgos identificados, el criterio de selección del microcontrolador y el presupuesto. Archivo: ELECTIVA/MQ4 - Propuesta de proyecto (carrito a control).docx [R2].

Apéndice D. Pruebas de verificación previstas: prueba de banco, prueba de calentamiento, prueba de consumo, prueba de alcance, prueba en pista y prueba de fallo del enlace. Cada prueba verifica los requisitos indicados en la tabla correspondiente del apartado 3.

Apéndice E. Parámetros marcados PRELIMINAR y dato del que depende cada uno:

— Alcance del enlace (30 m) y tasa de recepción (90 %), requisitos RF-01 y RF-09: dependen de la caracterización del control remoto.

— Tiempo de respuesta (150 ms ±20 ms), requisito RF-02: depende del protocolo del enlace y de la frecuencia del lazo de control.

— Frecuencia de PWM (20 kHz) y resolución (0,5 %), requisito RF-03: dependen del microcontrolador elegido y del calentamiento medido en el puente H.

— Tiempo muerto (1 µs), requisito RF-04: depende de los tiempos de conmutación de los transistores seleccionados.

— Tensión nominal (12 V) y rango de operación (6 V a 18 V), requisito RF-06: dependen de la batería y del motor disponibles.

— Tiempo de parada por pérdida de enlace (500 ms), requisito RF-07: depende de la cadencia de tramas del control.

— Tiempo de vinculación (5 s), requisito RF-08: depende de la tecnología del enlace.

— Visibilidad de las luces (5 m), requisito RF-10: depende de los LED seleccionados.

— Tiempo de aceleración hasta el 50 % de la velocidad máxima (2 s ±0,5 s), requisito RF-12: depende del motor, de la relación de transmisión y del peso final del vehículo.

— Tamaño máximo de cada celda de batería, apartado 2.4: depende de la batería que se consiga y del espacio disponible en el chasis.

— Autonomía (20 minutos), apartado 3.3.1: depende de la capacidad de la batería y del consumo medido.

Pueden contener todo tipo de información relevante para la SRS pero que, propiamente, no forme parte de la SRS.

Descripción de requisitos del sofware

Modelo de ingeniería [Nombre documento] 0.3 Pág. 3

Especificación de requisitos de software Rev. Pág. 5

Especificación de requisitos de software Rev. Pág. 4
