JoseAMS17/MQ4/Freecad/Rugged box/Rugged box freecad.FCStd

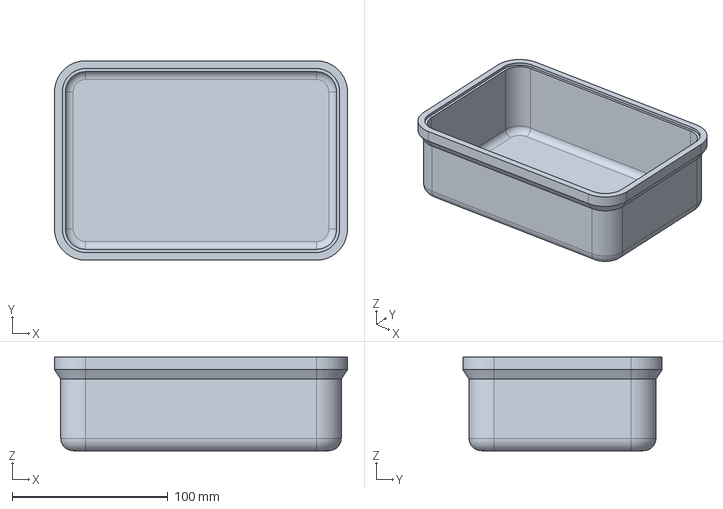
[picture p1: CAD file, 2026-11-05]
Freecad/Rugged box/Rugged box freecad.FCStd
188.0 x 128.0 x 60.0 mm
