JoseAMS17/MQ4/Freecad/Rugged box/Rugged box freecad26.3.FCStd

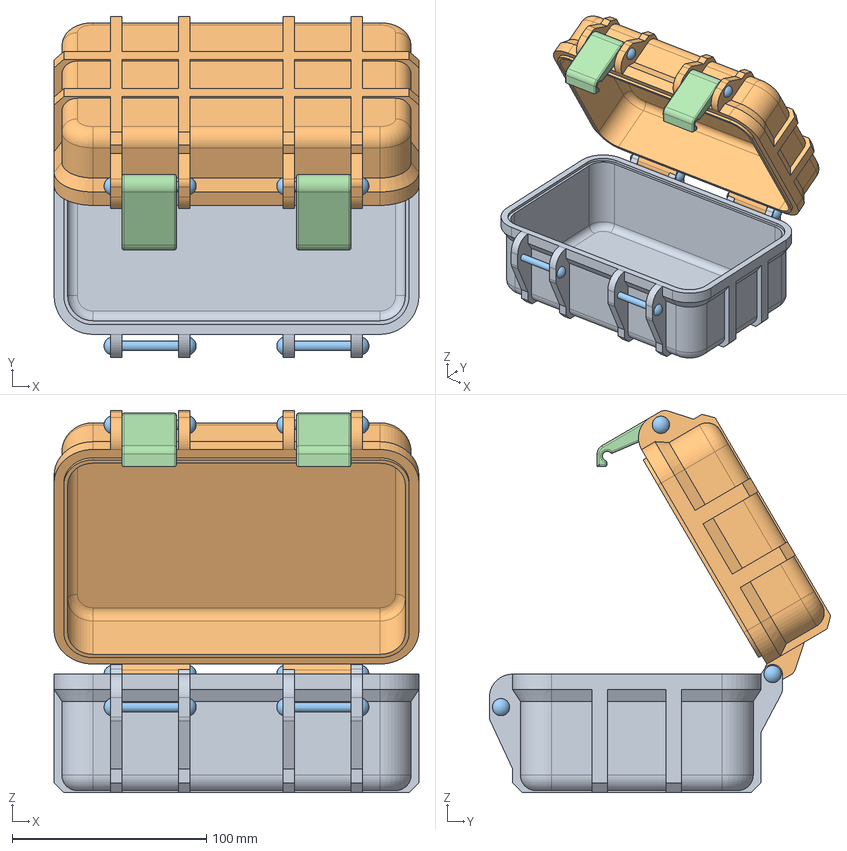
[picture p2: CAD file, 2026-11-05]
Freecad/Rugged box/Rugged box freecad26.3.FCStd
188.0 x 175.9 x 196.8 mm
Lid
Rivet x 6
Latch x 2
