JoseAMS17/MQ4/MQ4_Kicad/MQ4.kicad_pcb

## KiCad design MQ4_Kicad/MQ4.kicad_pcb (2026-11-14)

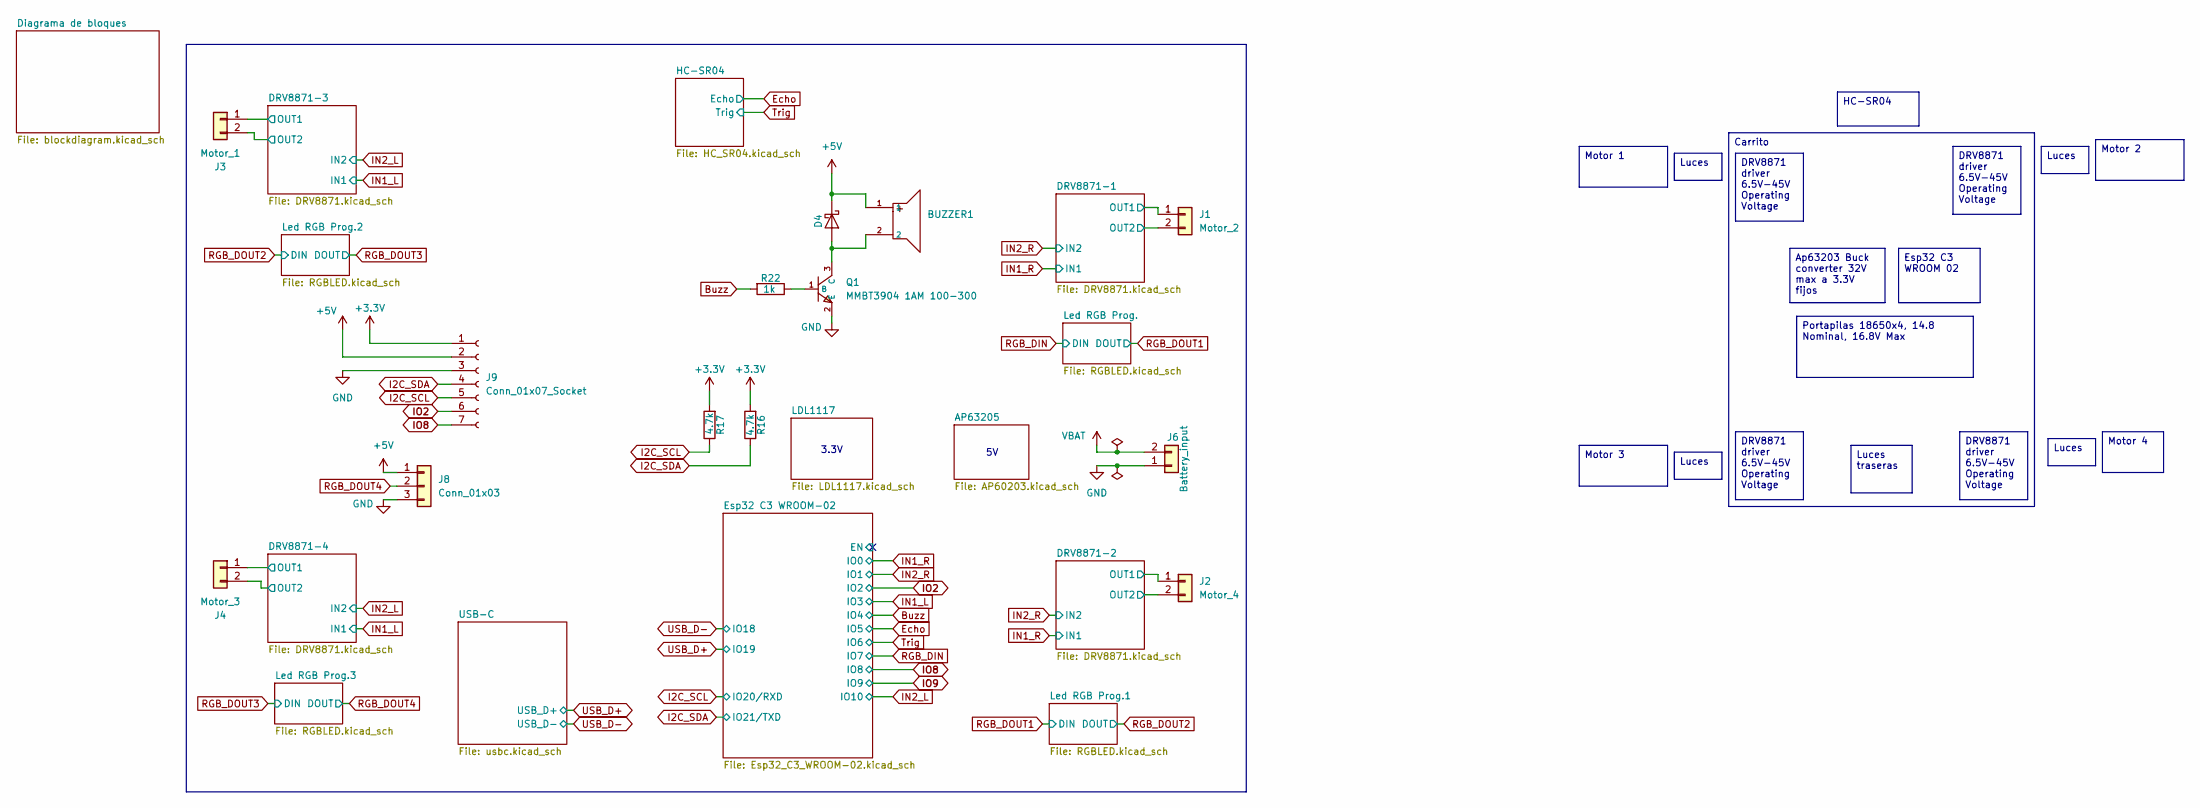
[picture p3: schematic MQ4.kicad_sch]

Parts:
BUZZER1: SEA-1295Y-0520-42Ω-38P6.5; C2687681_BUZ-TH_BD12_0-P6_50-D0_8; LCSC C2687681
D4: SMD22PL; D_SOD-123F
J1: Motor_2; Molex_KK-254_AE-6410-02A_1x02_P2.54mm_Vertical
J2: Motor_4; Molex_KK-254_AE-6410-02A_1x02_P2.54mm_Vertical
J3: Motor_1; Molex_KK-254_AE-6410-02A_1x02_P2.54mm_Vertical
J4: Motor_3; Molex_KK-254_AE-6410-02A_1x02_P2.54mm_Vertical
J6: Battery_input; Molex_KK-254_AE-6410-02A_1x02_P2.54mm_Vertical
J8: Conn_01x03; PinHeader_1x03_P2.54mm_Vertical
J9: Conn_01x07_Socket; PinSocket_1x07_P2.54mm_Vertical
Q1: MMBT3904 1AM 100-300; C20526_SOT-23-3_L2_9-W1_3-P1_90-LS2_4-BR; LCSC C20526
R16, R17: 4.7k; R_0805_2012Metric_Pad1.20x1.40mm_HandSolder
R22: 1k; R_0805_2012Metric_Pad1.20x1.40mm_HandSolder

Connections:
+3.3V: J9.1, R16.2, R17.2; also elsewhere on the board
+5V: BUZZER1.1, D4.1 (K), J8.1, J9.2; also elsewhere on the board
/DRV8871-1/OUT1: J1.1; also elsewhere on the board
/DRV8871-1/OUT2: J1.2; also elsewhere on the board
/DRV8871-2/OUT1: J2.1; also elsewhere on the board
/DRV8871-2/OUT2: J2.2; also elsewhere on the board
/DRV8871-3/OUT1: J3.1; also elsewhere on the board
/DRV8871-3/OUT2: J3.2; also elsewhere on the board
/DRV8871-4/OUT1: J4.1; also elsewhere on the board
/DRV8871-4/OUT2: J4.2; also elsewhere on the board
Buzz: R22.2; also elsewhere on the board
GND: J6.1, J8.3, J9.3, Q1.2 (E); also elsewhere on the board
I2C_SCL: J9.5, R17.1; also elsewhere on the board
I2C_SDA: J9.4, R16.1; also elsewhere on the board
IO2: J9.6; also elsewhere on the board
IO8: J9.7; also elsewhere on the board
unnamed: BUZZER1.2, D4.2 (A), Q1.3 (C)
unnamed: Q1.1 (B), R22.1
RGB_DOUT4: J8.2; also elsewhere on the board
VBAT: J6.2; also elsewhere on the board

Notes on the sheet:
3.3V
DRV8871 driver 6.5V-45V Operating Voltage
Luces
Esp32 C3 WROOM 02
Motor 2
Motor 3
Motor 4
HC-SR04
Motor 1
Luces traseras
Carrito
Ap63203 Buck converter 32V max a 3.3V fijos
Portapilas 18650x4, 14.8 Nominal, 16.8V Max

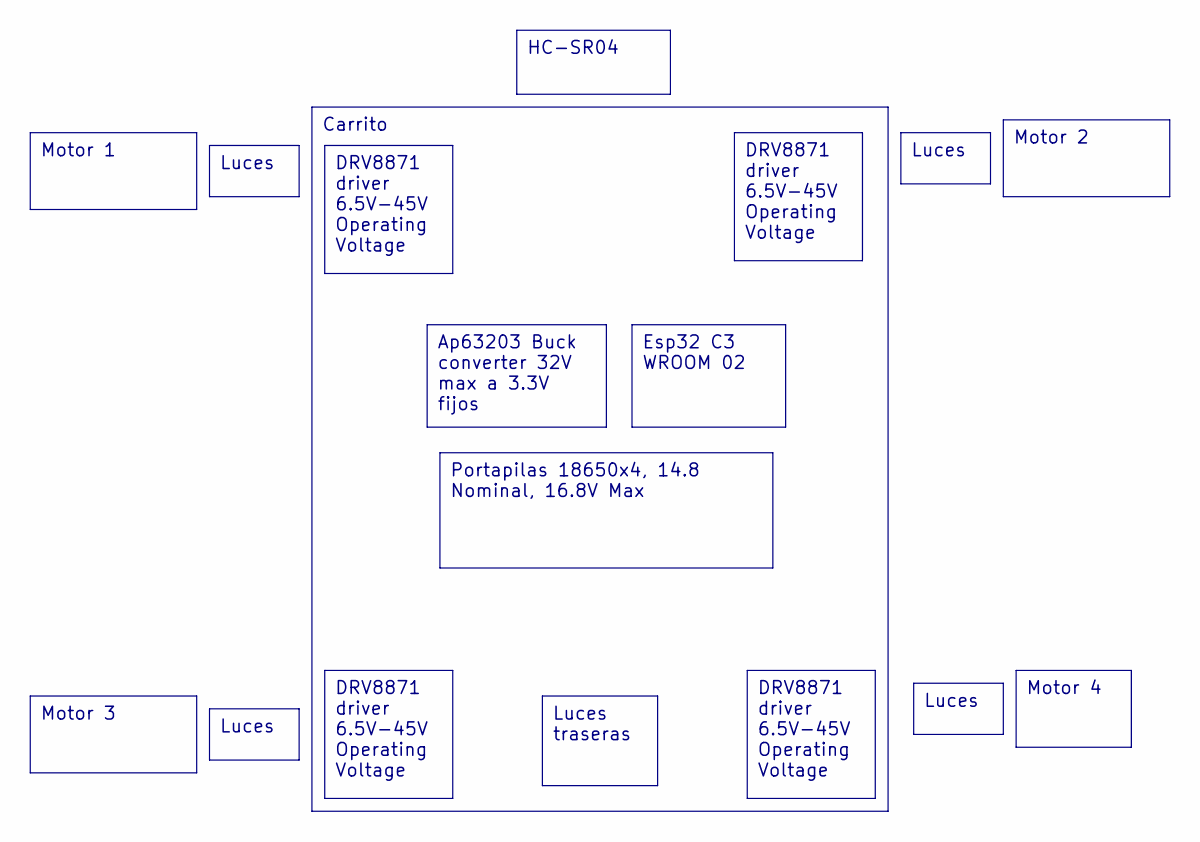
[picture p4: schematic blockdiagram.kicad_sch]

Notes on the sheet:
Luces
Motor 2
Luces traseras
Motor 3
Ap63203 Buck converter 32V max a 3.3V fijos
DRV8871 driver 6.5V-45V Operating Voltage
Carrito
Portapilas 18650x4, 14.8 Nominal, 16.8V Max
Esp32 C3 WROOM 02
HC-SR04
Motor 4
Motor 1

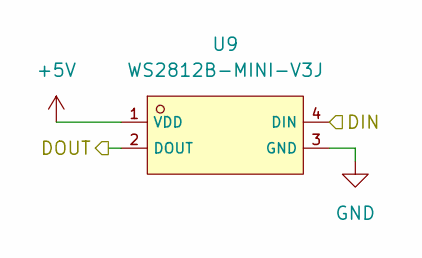
[picture p5: schematic RGBLED.kicad_sch]

Parts:
U9: WS2812B-MINI-V3J; C22371519_LED-SMD_4P-L3_5-W3_5-P1_80-LS6_2_WS2812B-MINI-V3J; LCSC C22371519

Connections:
+5V: U9.1 (VDD); also elsewhere on the board
GND: U9.3 (GND); also elsewhere on the board
RGB_DIN: U9.4 (DIN); also elsewhere on the board
RGB_DOUT1: U9.2 (DOUT); also elsewhere on the board

Parts of its further copies:
U10, U11, U12: WS2812B-MINI-V3J; C22371519_LED-SMD_4P-L3_5-W3_5-P1_80-LS6_2_WS2812B-MINI-V3J; LCSC C22371519

Connections of its further copies:
+5V: U10.1 (VDD), U11.1 (VDD), U12.1 (VDD); also elsewhere on the board
GND: U10.3 (GND), U11.3 (GND), U12.3 (GND); also elsewhere on the board
RGB_DOUT1: U10.4 (DIN); also elsewhere on the board
RGB_DOUT2: U10.2 (DOUT), U11.4 (DIN)
RGB_DOUT3: U11.2 (DOUT), U12.4 (DIN)
RGB_DOUT4: U12.2 (DOUT); also elsewhere on the board

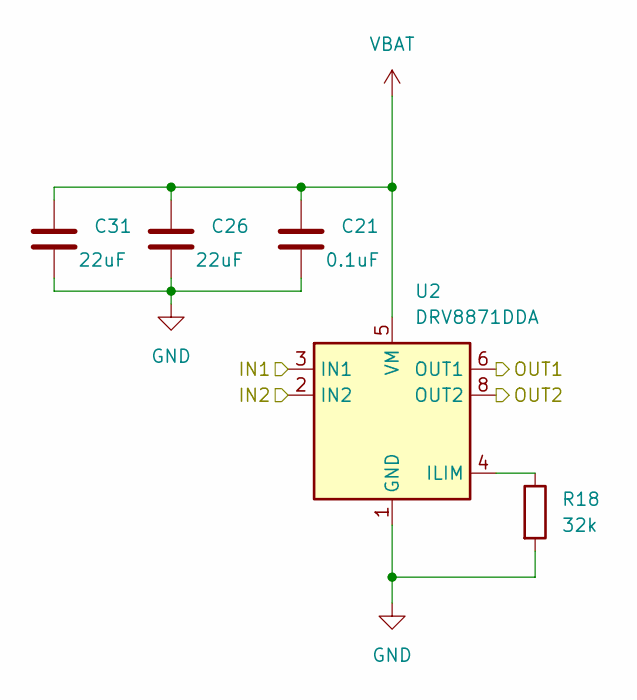
[picture p6: schematic DRV8871.kicad_sch]

Parts:
C21: 0.1uF; C_0805_2012Metric
C26, C31: 22uF; C_0805_2012Metric
R18: 32k; R_0805_2012Metric
U2: DRV8871DDA; Texas_HTSOP-8-1EP_3.9x4.9mm_P1.27mm_EP2.95x4.9mm_Mask2.4x3.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

Connections:
/DRV8871-2/OUT1: U2.6 (OUT1); also elsewhere on the board
/DRV8871-2/OUT2: U2.8 (OUT2); also elsewhere on the board
GND: C21.2, C26.2, C31.2, R18.2, U2.1 (GND), U2.7 (GND), U2.9 (GND); also elsewhere on the board
IN1_R: U2.3 (IN1); also elsewhere on the board
IN2_R: U2.2 (IN2); also elsewhere on the board
unnamed: R18.1, U2.4 (ILIM)
VBAT: C21.1, C26.1, C31.1, U2.5 (VM); also elsewhere on the board

Parts of its further copies:
C23, C25, C27: 0.1uF; C_0805_2012Metric
C28, C29, C30, C32, C33, C34: 22uF; C_0805_2012Metric
R19, R20, R21: 32k; R_0805_2012Metric
U1, U3, U4: DRV8871DDA; Texas_HTSOP-8-1EP_3.9x4.9mm_P1.27mm_EP2.95x4.9mm_Mask2.4x3.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

Connections of its further copies:
/DRV8871-1/OUT1: U1.6 (OUT1); also elsewhere on the board
/DRV8871-1/OUT2: U1.8 (OUT2); also elsewhere on the board
/DRV8871-3/OUT1: U3.6 (OUT1); also elsewhere on the board
/DRV8871-3/OUT2: U3.8 (OUT2); also elsewhere on the board
/DRV8871-4/OUT1: U4.6 (OUT1); also elsewhere on the board
/DRV8871-4/OUT2: U4.8 (OUT2); also elsewhere on the board
GND: C23.2, C25.2, C27.2, C28.2, C29.2, C30.2, C32.2, C33.2, C34.2, R19.2, R20.2, R21.2, U1.1 (GND), U1.7 (GND), U1.9 (GND), U3.1 (GND), U3.7 (GND), U3.9 (GND), U4.1 (GND), U4.7 (GND), U4.9 (GND); also elsewhere on the board
IN1_L: U3.3 (IN1), U4.3 (IN1); also elsewhere on the board
IN1_R: U1.3 (IN1); also elsewhere on the board
IN2_L: U3.2 (IN2), U4.2 (IN2); also elsewhere on the board
IN2_R: U1.2 (IN2); also elsewhere on the board
unnamed: R21.1, U1.4 (ILIM)
unnamed: R19.1, U3.4 (ILIM)
unnamed: R20.1, U4.4 (ILIM)
VBAT: C23.1, C25.1, C27.1, C28.1, C29.1, C30.1, C32.1, C33.1, C34.1, U1.5 (VM), U3.5 (VM), U4.5 (VM); also elsewhere on the board

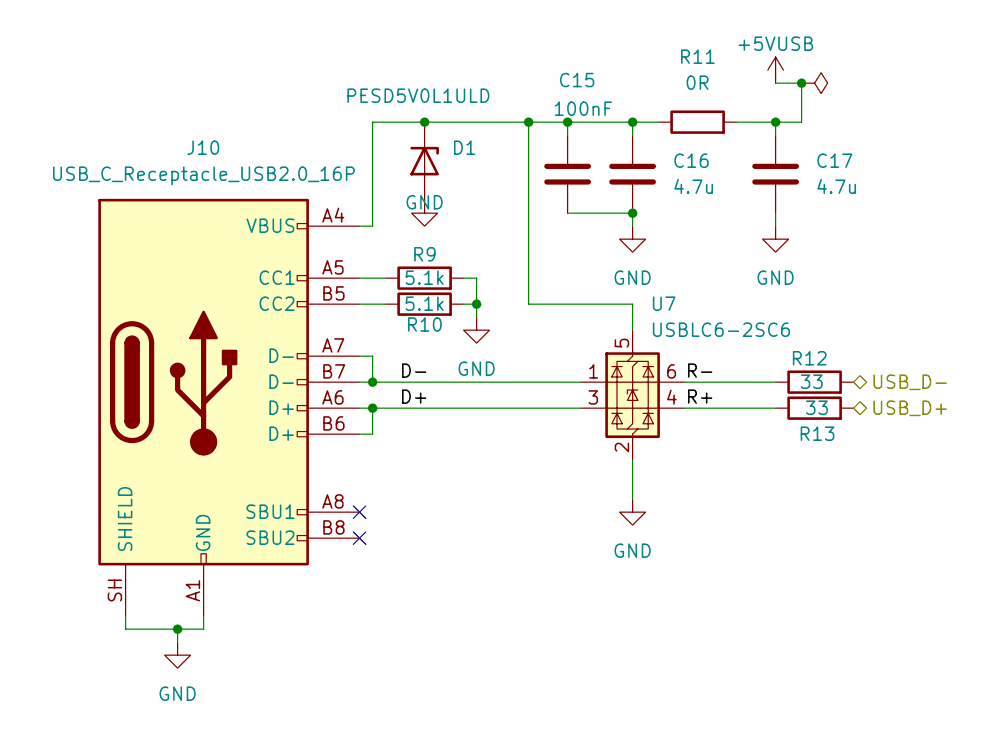
[picture p7: schematic usbc.kicad_sch]

Parts:
C15: 100nF; C_0805_2012Metric
C16, C17: 4.7u; C_0805_2012Metric
D1: PESD5V0L1ULD; D_SOD-882D
J10: USB_C_Receptacle_USB2.0_16P; USB_C_Receptacle_G-Switch_GT-USB-7010ASV
R9, R10: 5.1k; R_0805_2012Metric_Pad1.20x1.40mm_HandSolder
R11: 0R; R_0805_2012Metric
R12, R13: 33; R_0805_2012Metric
U7: USBLC6-2SC6; SOT-23-6

Connections:
+5VUSB: C17.1, R11.2; also elsewhere on the board
/USB-C/D+: J10.A6 (D+), J10.B6 (D+), U7.3 (I/O2)
/USB-C/D-: J10.A7 (D-), J10.B7 (D-), U7.1 (I/O1)
/USB-C/R+: R13.1, U7.4 (I/O2)
/USB-C/R-: R12.1, U7.6 (I/O1)
GND: C15.2, C16.2, C17.2, D1.2 (A), J10.A1 (GND), J10.A12 (GND), J10.B1 (GND), J10.B12 (GND), J10.SH (SHIELD), R9.2, R10.2, U7.2 (GND); also elsewhere on the board
unnamed: C15.1, C16.1, D1.1 (K), J10.A4 (VBUS), J10.A9 (VBUS), J10.B4 (VBUS), J10.B9 (VBUS), R11.1, U7.5 (VBUS)
unnamed: J10.A5 (CC1), R9.1
unnamed: J10.B5 (CC2), R10.1
USB_D+: R13.2; also elsewhere on the board
USB_D-: R12.2; also elsewhere on the board

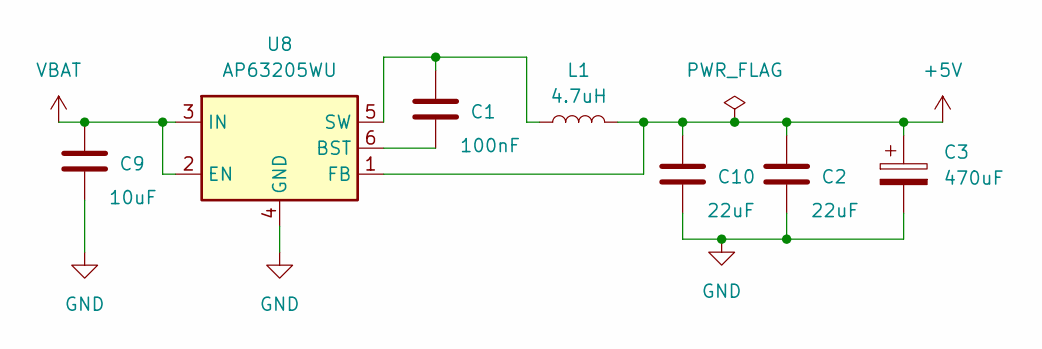
[picture p8: schematic AP60203.kicad_sch]

Parts:
C1: 100nF; C_0805_2012Metric
C2, C10: 22uF; C_0805_2012Metric
C3: 470uF; CP_Radial_D10.0mm_P3.50mm
C9: 10uF; C_0805_2012Metric
L1: 4.7uH; L_APV_APH0630
U8: AP63205WU; TSOT-23-6

Connections:
+5V: C2.1, C3.1, C10.1, L1.2, U8.1 (FB); also elsewhere on the board
GND: C2.2, C3.2, C9.2, C10.2, U8.4 (GND); also elsewhere on the board
unnamed: C1.2, U8.6 (BST)
unnamed: C1.1, L1.1, U8.5 (SW)
VBAT: C9.1, U8.2 (EN), U8.3 (IN); also elsewhere on the board

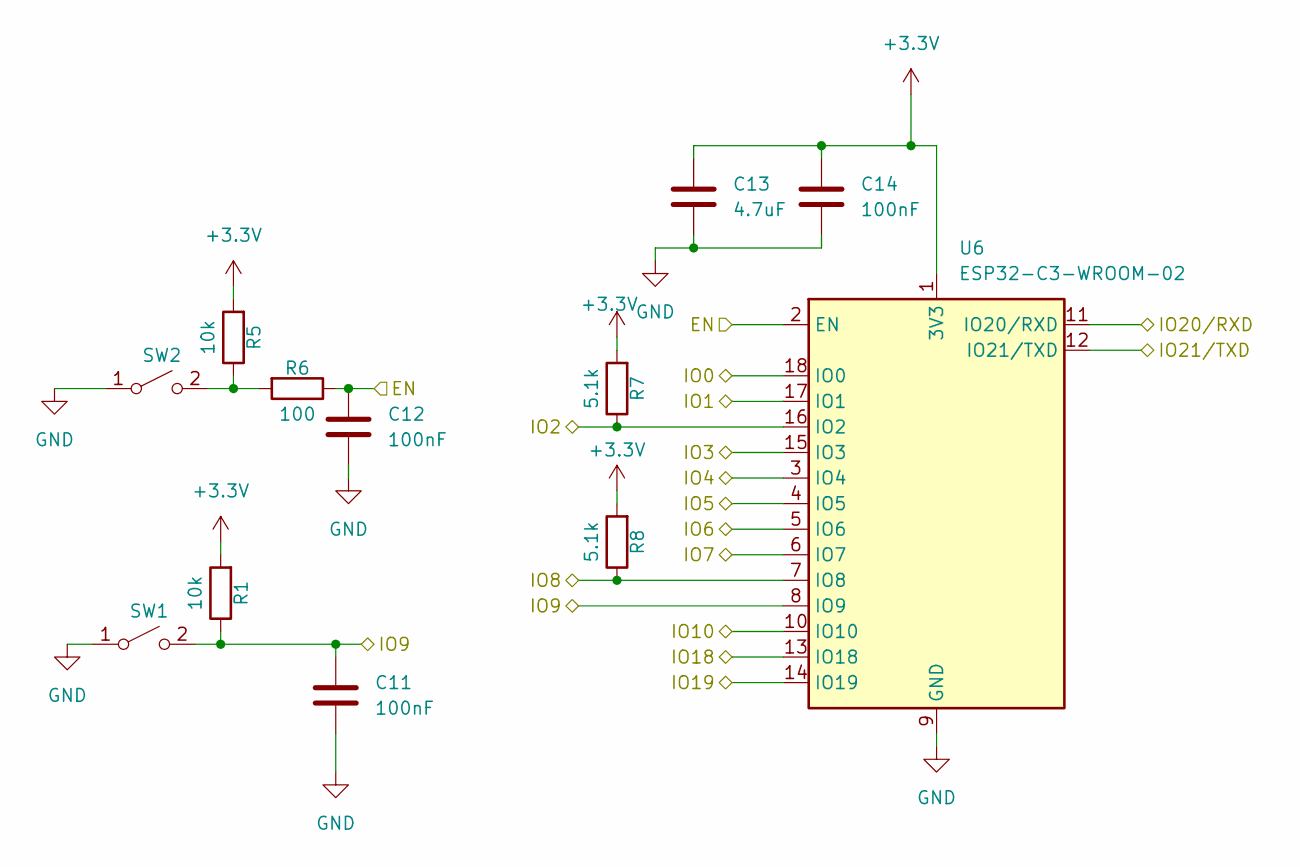
[picture p9: schematic Esp32_C3_WROOM-02.kicad_sch]

Parts:
C11, C12, C14: 100nF; C_0805_2012Metric_Pad1.18x1.45mm_HandSolder
C13: 4.7uF; C_0805_2012Metric_Pad1.18x1.45mm_HandSolder
R1, R5: 10k; R_0805_2012Metric_Pad1.20x1.40mm_HandSolder
R6: 100; R_0805_2012Metric_Pad1.20x1.40mm_HandSolder
R7, R8: 5.1k; R_0805_2012Metric_Pad1.20x1.40mm_HandSolder
SW1, SW2: SW_SPST; SW_SPST_B3U-1000P
U6: ESP32-C3-WROOM-02; C2934560_BULETM-SMD_ESPRESSIF_ESP32-C3-WROOM-02-N4-4MB

Connections:
+3.3V: C13.1, C14.1, R1.2, R5.2, R7.2, R8.2, U6.1 (3V3); also elsewhere on the board
/Esp32 C3 WROOM-02/EN: C12.1, R6.1, U6.2 (EN)
Buzz: U6.3 (IO4); also elsewhere on the board
Echo: U6.4 (IO5); also elsewhere on the board
GND: C11.2, C12.2, C13.2, C14.2, SW1.1 (A), SW2.1 (A), U6.9 (GND), U6.19 (GND); also elsewhere on the board
I2C_SCL: U6.11 (IO20/RXD); also elsewhere on the board
I2C_SDA: U6.12 (IO21/TXD); also elsewhere on the board
IN1_L: U6.15 (IO3); also elsewhere on the board
IN1_R: U6.18 (IO0); also elsewhere on the board
IN2_L: U6.10 (IO10); also elsewhere on the board
IN2_R: U6.17 (IO1); also elsewhere on the board
IO2: R7.1, U6.16 (IO2); also elsewhere on the board
IO8: R8.1, U6.7 (IO8); also elsewhere on the board
IO9: C11.1, R1.1, SW1.2 (B), U6.8 (IO9)
unnamed: R5.1, R6.2, SW2.2 (B)
RGB_DIN: U6.6 (IO7); also elsewhere on the board
Trig: U6.5 (IO6); also elsewhere on the board
USB_D+: U6.14 (IO19); also elsewhere on the board
USB_D-: U6.13 (IO18); also elsewhere on the board

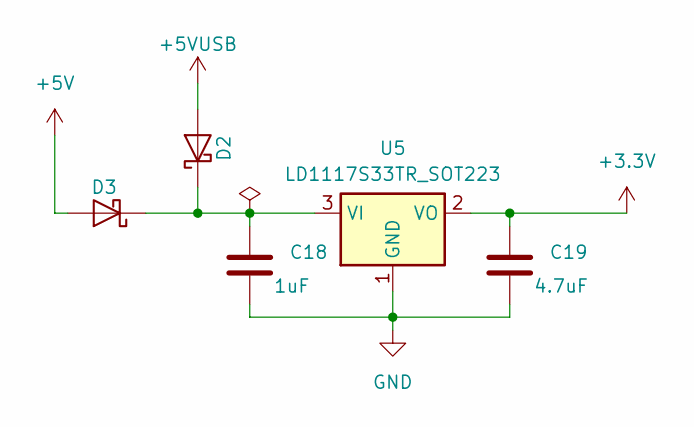
[picture p10: schematic LDL1117.kicad_sch]

Parts:
C18: 1uF; C_0805_2012Metric
C19: 4.7uF; C_0805_2012Metric
D2, D3: SMD22PL; D_SOD-123F
U5: LD1117S33TR_SOT223; SOT-223-3_TabPin2

Connections:
+3.3V: C19.1, U5.2 (VO); also elsewhere on the board
+5V: D3.2 (A); also elsewhere on the board
+5VUSB: D2.2 (A); also elsewhere on the board
GND: C18.2, C19.2, U5.1 (GND); also elsewhere on the board
unnamed: C18.1, D2.1 (K), D3.1 (K), U5.3 (VI)

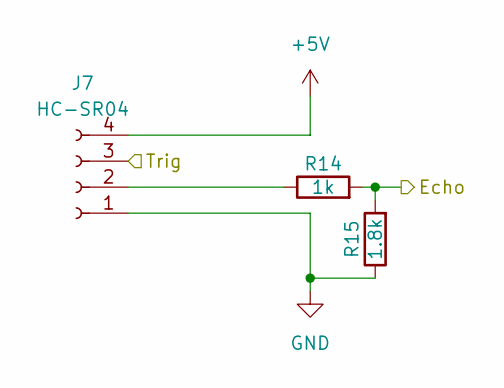
[picture p11: schematic HC_SR04.kicad_sch]

Parts:
J7: HC-SR04; PinSocket_1x04_P2.54mm_Vertical
R14: 1k; R_0805_2012Metric
R15: 1.8k; R_0805_2012Metric

Connections:
+5V: J7.4; also elsewhere on the board
Echo: R14.2, R15.2; also elsewhere on the board
GND: J7.1, R15.1; also elsewhere on the board
unnamed: J7.2, R14.1
Trig: J7.3; also elsewhere on the board

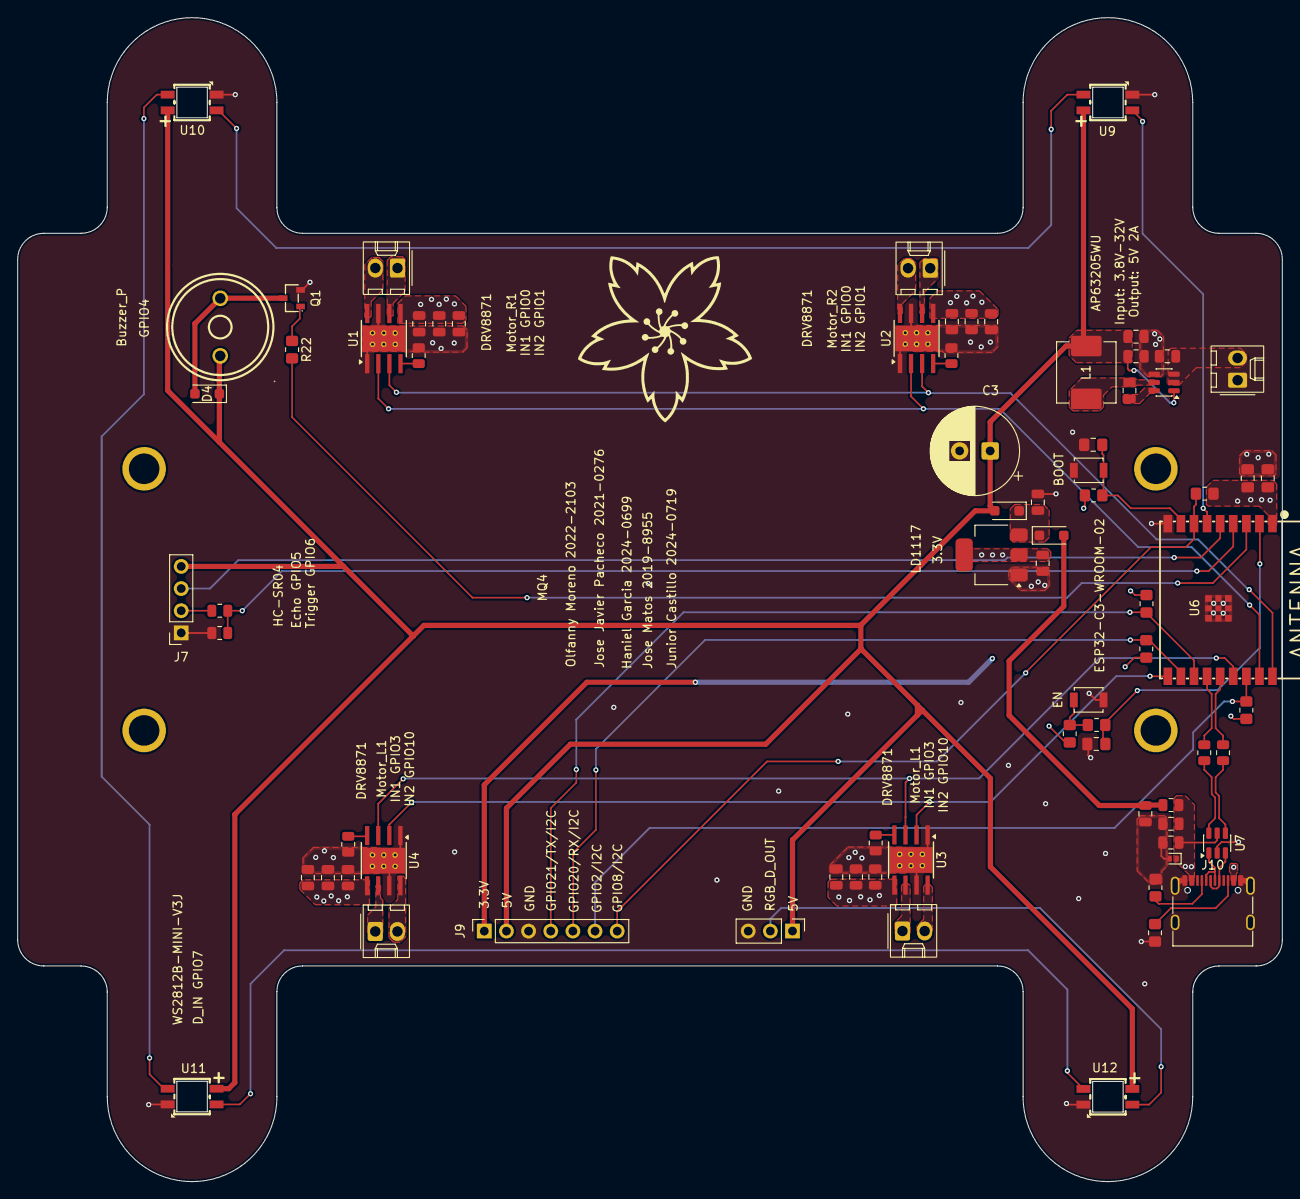
[picture p12: board MQ4.kicad_pcb from above]

Board: 4 copper layers, 145.0 x 133.5 mm, 75 parts (0 on the bottom side), 51 nets.
