JoseAMS17/MQ4/(commit log)

2026-10-21 Primer commit
    [MQ4.kicad_pcb, MQ4.kicad_sch, blockdiagram.kicad_sch, power.kicad_sch, untitled.kicad_sch]
2026-10-22 Avance de esquematicos
    [AP60203.kicad_sch, DRV8871.kicad_sch, Esp32_C3_WROOM-02.kicad_sch, MQ4.kicad_sch, power.kicad_sch, untitled.kicad_sch]
2026-10-29 Ajustes 2
    [MQ4.kicad_sch, RGBLED.kicad_sch]
2026-10-29 Ajustes 3
    [AP60203.kicad_sch, DRV8871.kicad_sch, Esp32_C3_WROOM-02.kicad_sch, LDL1117.kicad_sch, MQ4.kicad_sch, usbc.kicad_sch]
2026-11-04 Leds RGB reversos y ajustes finales de esquematicos
    [AP60203.kicad_sch, Esp32_C3_WROOM-02.kicad_sch, MQ4.kicad_pcb, MQ4.kicad_sch, RGBLED.kicad_sch]
2026-11-05 Reorganizacion de repositorio
    [AP60203.kicad_sch, DRV8871.kicad_sch, Esp32_C3_WROOM-02.kicad_sch, HC_SR04.kicad_sch, LDL1117.kicad_sch, MQ4.kicad_pcb, MQ4.kicad_sch, Rugged box freecad.FCStd]
2026-11-05 Reorganizacion de repo 2
    [Rugged box freecad.FCStd, Rugged box freecad26.3.FCStd]
2026-11-05 Board outline
    [DRV8871.kicad_sch, MQ4.kicad_pcb, MQ4.kicad_sch]
2026-11-05 Dimensiones de board 2
    [MQ4.kicad_pcb]
2026-11-07 Leds rgb encima de las ruedas en pcb
    [MQ4.kicad_pcb]
2026-11-09 Avance enrutado 1
    [DRV8871.kicad_sch, MQ4.kicad_pcb, MQ4.kicad_sch]
2026-11-12 Ajustes PCB 2
    [MQ4.kicad_pcb]
2026-11-12 Buzzer y pin headers a pines no usados
    [MQ4.kicad_pcb, MQ4.kicad_sch, usbc.kicad_sch]
2026-11-12 Buzzer y Reposicion de la entrada de voltaje
    [MQ4.kicad_pcb, usbc.kicad_sch]
2026-11-14 Capacitor en 5V y datos silkscreen
    [AP60203.kicad_sch, Esp32_C3_WROOM-02.kicad_sch, MQ4.kicad_pcb]
2026-11-14 Avance silkscreen 2
    [MQ4.kicad_pcb]
2026-11-14 Arreglos silkscreen 1
    [MQ4.kicad_pcb]
